ibbu98/Board-1_555_Timer/Layout/555_timer_Layout.pdf

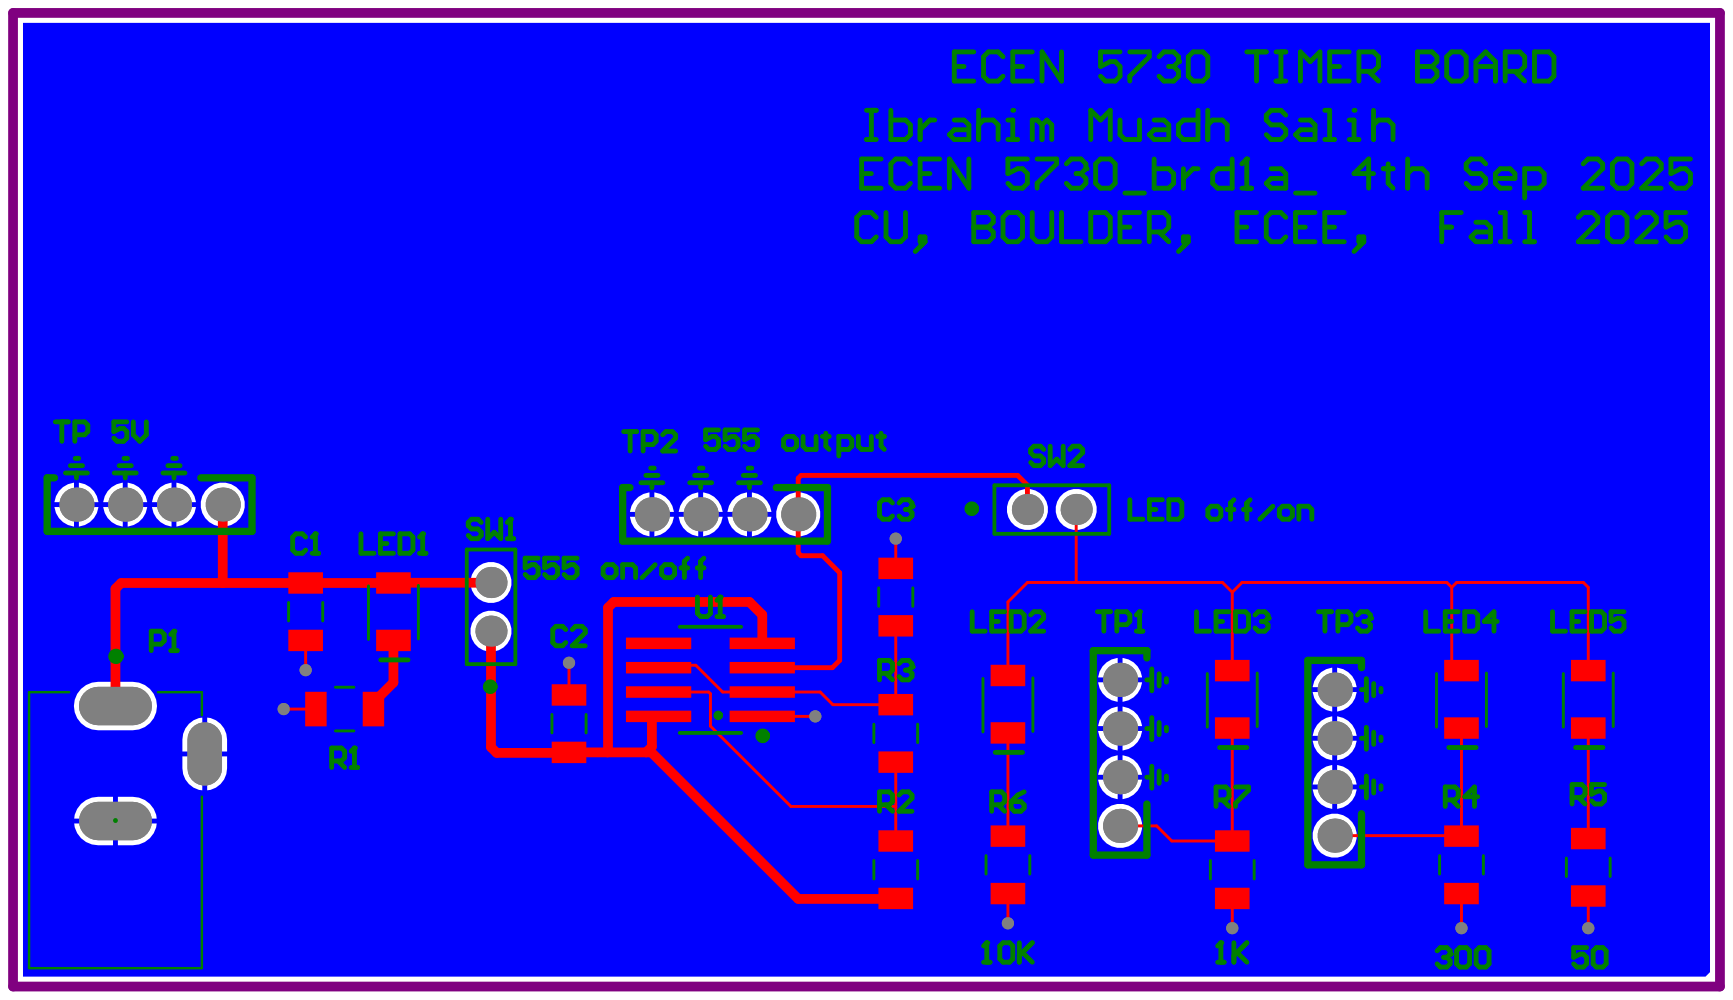
[picture p26: page 1]
