ibbu98/Board-1_555_Timer/(list of files, drawings)

Other design files:
Layout/555_timer.PcbDoc
schematic/555_timer.SchDoc
