ibbu98/Board-1_555_Timer/(commit log)

2025-11-15 Add README for 555 Timer schematics
2025-11-15 Add README for BOARD 1 - 555 TIMER LAYOUT
